PRIArobotics/Hedgehog_PCB/Doc/Pinout_STM_RPi.xlsx

Sheet: STM
Pin | Name | ADC | Timer |  |  | Com |  |  | Used For
1 | E2 |  |  |  |  | SPI4_SCK |  |  | IMU SCK
2 | E3 |  |  |  |  |  |  |  | IMU INT
3 | E4 |  |  |  |  | SPI4_NSS |  |  | IMU NCS
4 | E5 |  | TIM9_CH1 |  |  | SPI4_MISO |  |  | IMU MISO
5 | E6 |  | TIM9_CH2 |  |  | SPI4_MOSI |  |  | IMU MOSI
6 | VBAT |  |  |  |  |  |  |  | Power In Sense
7 | C13 |  |  |  |  |  |  |  | Motor 0/1 Mode
8 | C14-OSC32_IN |  |  |  |  |  |  |  | Motor 2 B
9 | C15-OSC32_OUT |  |  |  |  |  |  |  | Motor 3 B
10 | VSS
11 | VDD
12 | H0-OSC_IN |  |  |  |  |  |  |  | Crystal (optional)
13 | H1-OSC_OUT |  |  |  |  |  |  |  | Crystal (optional)
14 | NRST |  |  |  |  |  |  |  | NRST (controlled by RPi)
15 | C0 | ADC1_IN10 |  |  |  |  |  |  | IO_15 Analog
16 | C1 | ADC1_IN11 |  |  |  |  |  |  | IO_14 Analog
17 | C2 | ADC1_IN12 |  |  |  | SPI2_MISO |  |  | IO_7 Analog
18 | C3 | ADC1_IN13 |  |  |  | SPI2_MOSI |  |  | IO_6 Analog
19 | VDD
20 | VSSA, VREF-
21 | VREF+
22 | VDDA
23 | A0 | ADC1_IN0 | TIM2_CH1 | TIM5_CH1 |  | USART2_CTS |  |  | IO_5 Analog
24 | A1 | ADC1_IN1 | TIM2_CH2 | TIM5_CH2 |  | USART2_RTS |  |  | IO_4 Analog
25 | A2 | ADC1_IN2 | TIM2_CH3 | TIM5_CH3 | TIM9_CH1 | USART2_TX |  |  | IO_3 Analog
26 | A3 | ADC1_IN3 | TIM2_CH4 | TIM5_CH4 | TIM9_CH2 | USART2_RX |  |  | IO_2 Analog
27 | VSS
28 | VDD
29 | A4 | ADC1_IN4 |  |  |  | SPI1_NSS | SPI3_NSS | USART2_CK | IO_1 Analog
30 | A5 | ADC1_IN5 | TIM2_CH1 |  |  | SPI1_SCK |  |  | IO_0 Analog
31 | A6 | ADC1_IN6 | TIM3_CH1 |  |  | SPI1_MISO |  |  | IO_8 Analog
32 | A7 | ADC1_IN7 | TIM3_CH2 |  |  | SPI1_MOSI |  |  | IO_9 Analog
33 | C4 | ADC1_IN14 |  |  |  |  |  |  | IO_10 Analog
34 | C5 | ADC1_IN15 |  |  |  |  |  |  | IO_11 Analog
35 | B0 | ADC1_IN8 | TIM3_CH3 |  |  |  |  |  | IO_12 Analog
36 | B1 | ADC1_IN9 | TIM3_CH4 |  |  |  |  |  | IO_13 Analog
37 | B2 |  |  |  |  |  |  |  | PG REG MS
38 | E7 |  |  |  |  |  |  |  | Motor 3 A
39 | E8 |  | TIM1_CH1N |  |  |  |  |  | Speaker -
40 | E9 |  | TIM1_CH1 |  |  |  |  |  | Speaker +
41 | E10 |  |  |  |  |  |  |  | IO_13
42 | E11 |  | TIM1_CH2 |  |  | SPI4_NSS |  |  | IO_12
43 | E12 |  |  |  |  | SPI4_SCK |  |  | IO_11
44 | E13 |  | TIM1_CH3 |  |  | SPI4_MISO |  |  | IO_10
45 | E14 |  | TIM1_CH4 |  |  | SPI4_MOSI |  |  | IO_9
46 | E15 |  |  |  |  |  |  |  | IO_8
47 | B10 |  | TIM2_CH3 |  |  | SPI2_SCK | I2C2_SCL |  | Power LED
48 | VCAP_1
49 | VSS
50 | VDD
51 | B12 |  |  |  |  | SPI2_NSS | I2C2_SMBA |  | SPI EXT 1
52 | B13 |  |  |  |  | SPI2_SCK |  |  | SPI EXT 1
53 | B14 |  |  |  |  | SPI2_MISO |  |  | SPI EXT 1
54 | B15 |  |  |  |  | SPI2_MOSI |  |  | SPI EXT 1
55 | D8 |  |  |  |  |  |  |  | EN Reg RPi
56 | D9 |  |  |  |  |  |  |  | EN Reg MS
57 | D10 |  |  |  |  |  |  |  | EN PWR IN
58 | D11 |  |  |  |  |  |  |  | Power Button State
59 | D12 |  | TIM4_CH1 |  |  |  |  |  | Servo 5
60 | D13 |  | TIM4_CH2 |  |  |  |  |  | Servo 4
61 | D14 |  | TIM4_CH3 |  |  |  |  |  | Servo 3
62 | D15 |  | TIM4_CH4 |  |  |  |  |  | Servo 2
63 | C6 |  | TIM3_CH1 |  |  | USART6_TX |  |  | Servo 1
64 | C7 |  | TIM3_CH2 |  |  | USART6_RX |  |  | Servo 0
65 | C8 |  | TIM3_CH3 |  |  | USART6_CK |  |  | Motor 1 B
66 | C9 |  | TIM3_CH4 |  |  | I2C3_SDA |  |  | Motor 0 A
67 | A8 |  | TIM1_CH1 |  |  | I2C3_SCL | USART1_CK |  | Motor 2 A
68 | A9 |  | TIM1_CH2 |  |  | I2C3_SMBA | USART1_TX |  | UART to RPi
69 | A10 |  | TIM1_CH3 |  |  | USART1_RX |  |  | UART to RPi
70 | A11 |  | TIM1_CH4 |  |  | USART1_CTS | USART6_TX |  | UART EXT 1
71 | A12 |  |  |  |  | USART1_RTS | USART6_RX |  | UART EXT 1
72 | A13 |  |  |  |  |  |  |  | JTMS/SWDIO (controlled by RPi)
73 | V_CAP_2
74 | VSS
75 | VDD
76 | A14 |  |  |  |  |  |  |  | JTCK/SWCLK (controlled by RPi)
77 | A15 |  | TIM2_CH1 |  |  | SPI1_NSS | SPI3_NSS |  | JTDI (controlled by RPi)
78 | C10 |  |  |  |  | SPI3_SCK |  |  | RPi Active Sense
79 | C11 |  |  |  |  | SPI3_MISO |  |  | Motor 1 A
80 | C12 |  |  |  |  | SPI3_MOSI |  |  | Motor 0 B
81 | D0 |  |  |  |  |  |  |  | IO_0
82 | D1 |  |  |  |  |  |  |  | IO_1
83 | D2 |  |  |  |  |  |  |  | IO_2
84 | D3 |  |  |  |  | SPI2_SCK | USART2_CTS |  | IO_3
85 | D4 |  |  |  |  |  | USART2_RTS |  | IO_4
86 | D5 |  |  |  |  |  | USART2_TX |  | IO_5
87 | D6 |  |  |  |  | SPI3_MOSI | USART2_RX |  | IO_6
88 | D7 |  |  |  |  |  | USART2_CK |  | IO_7
89 | B3 |  | TIM2_CH2 |  |  | SPI1_SCK | SPI3_SCK | I2C_SDA | JTDO/SWO (controlled by RPi)
90 | B4 |  | TIM3_CH1 |  |  | SPI1_MISO | SPI3_MISO |  | NJTRST (controlled by RPi)
91 | B5 |  | TIM3_CH2 |  |  | SPI1_MOSI | SPI3_MOSI |  | Motor 2/3 Mode
92 | B6 |  | TIM4_CH1 |  |  | I2C1_SCL | USART1_TX |  | I2C EXT 1
93 | B7 |  | TIM4_CH2 |  |  | I2C1_SDA | USART1_RX |  | I2C EXT 1
94 | BOOT0 |  |  |  |  |  |  |  | BOOT0 (controlled by RPi)
95 | B8 |  | TIM4_CH3 | TIM10_CH1 |  | I2C1_SCL |  |  | LED0 (D40)
96 | B9 |  | TIM4_CH4 | TIM11_CH1 |  | SPI2_NSS | I2C1_SDA |  | LED1 (D41)
97 | E0 |  |  |  |  |  |  |  | IO_14
98 | E1 |  |  |  |  |  |  |  | IO_15
99 | VSS
100 | VDD

Sheet: RPi
Pin | Name | Com | Used for
1 | 3V3
2 | 5V
3 | GPIO02 | SDA | I2C EXT 0
4 | 5V
5 | GPIO03 | SCL | I2C EXT 0
6 | GND
7 | GPIO04
8 | GPIO14 | TXD | UART to STM
9 | GND
10 | GPIO15 | RXD | UART to STM
11 | GPIO17 |  | STM NJTRST
12 | GPIO18
13 | GPIO27 |  | STM JTDO/SWO
14 | GND
15 | GOIO22 |  | STM JTDI
16 | GPIO23 |  | EN PWR IN
17 | 3V3
18 | GPIO24 |  | EN Reg RPi
19 | GPIO10 | MOSI | SPI EXT 0
20 | GND
21 | GPIO09 | MISO | SPI EXT 0
22 | GPIO25
23 | GPIO11 | CLK | SPI EXT 0
24 | GPIO08 | CE0 | SPI EXT 0_0
25 | GND
26 | GPIO07 | CE1 | SPI EXT 0_1
27 | ID_SD
28 | ID_SC
29 | GPIO05 |  | STM NRST
30 | GND
31 | GPIO06 |  | STM BOOT0
32 | GPIO12
33 | GPIO13 |  | STM JTCK/SWCLK
34 | GND
35 | GPIO19 |  | STM JTMS/SWDIO
36 | GPIO16 |  | RPi Active Output
37 | GPIO26 |  | STM NRST EN
38 | GPIO20 |  | LED3 (D43)
39 | GND
40 | GPIO21 |  | LED2 (D42)
