PRIArobotics/Hedgehog_PCB/Doc/Assembly_RefDes.pdf

R44C11

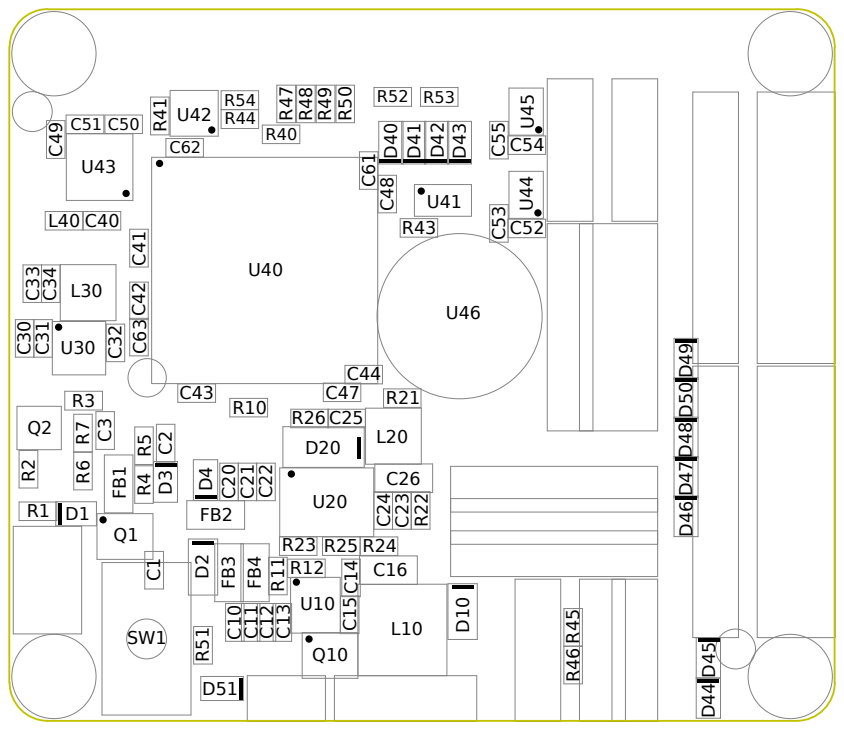
[picture p1: page 1]

R23 | R25 | R24
R12 | | | C16
