PRIArobotics/Hedgehog_PCB/Doc/Assembly_Mask.pdf

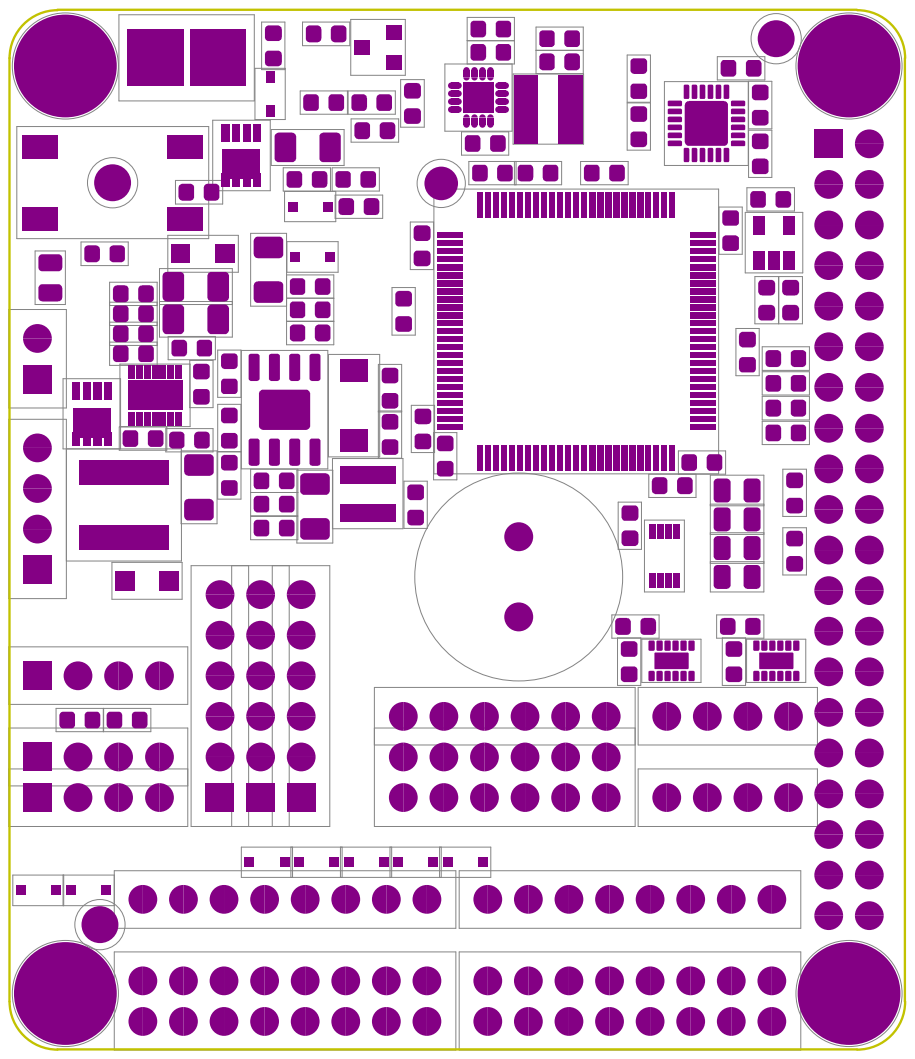
[picture p2: page 1]
