PRIArobotics/Hedgehog_PCB/(commit log)

2017-03-23 added motor driver to libraries
2017-04-18 Added hierarchical Design on Top Layer in eschematic.
    Added File for 3V3-regulator, Switching Regulator for RPI and Switching Regulator Motor and Servo. Added File for Hedgehog Logic design, which include the microcontroller-, Motordriverschematic,…
    [3V3-Regler.sch, Logic_Hedgehog.sch, Motortreiber.sch, STM.sch, Schaltregler_Motor_Servo.sch, Schaltregler_Raspberry.sch]
2017-04-18 Added IMU schematic -> InvenSense-ICM-20689
    [3V3-Regler.sch, Hedgehog.sch, Logic_Hedgehog.sch, Motortreiber.sch, STM.sch, Schaltregler_Motor_Servo.sch, Schaltregler_Raspberry.sch]
2017-04-19 Added MOSFET component Added Button component Added On-Off-Switch schematic
    [3V3-Regler.sch, Hedgehog.sch, Motortreiber.sch]
2017-04-19 Added Piezo Buzzer in Libray Added Piezo Buzzer schematic Added Pinout for STM32 SWDIO / JTAG is missing
    [Hedgehog.sch, Logic_Hedgehog.sch]
2017-04-21 placed Battery measurement circuit behind mosfet and added a zener diode
    [Hedgehog.sch]
2017-04-30 Added IMU Files
    [IMU.sch]
2017-04-30 removed duplicateproject file
    [Hedgehog.kicad_pcb]
2017-04-30 added pcb backup file
2017-04-30 more cleanup
    [Logic_Hedgehog.sch, Motor_Drivers.sch]
2017-04-30 added mosfet footprint some more cleanup
    [Hedgehog.sch, IMU.sch, Logic_Hedgehog.sch]
2017-04-30 added RPi Regulator added ref.des.-prefixes to all schematic sheets
    [Hedgehog.sch, IMU.sch, Logic_Hedgehog.sch, Motor_Drivers.sch, Reg_3V3.sch, Reg_5V_MS.sch, Reg_5V_RPi.sch, STM.sch]
2017-04-30 added 3v3 regulator
    [Hedgehog.sch, Reg_3V3.sch, Reg_5V_RPi.sch]
2017-04-30 added note
    [Reg_5V_MS.sch]
2017-05-01 added Motor/Servo 5V regulator
    [Hedgehog.sch, Reg_3V3.sch, Reg_5V_MS.sch]
2017-05-04 moved stuff from other sheet to Logic sheet cleanup added connections schematic nearly finished
    [Hedgehog.sch, IMU.sch, Logic_Hedgehog.sch, Motor_Drivers.sch, Reg_3V3.sch, Reg_5V_MS.sch, Reg_5V_RPi.sch, STM.sch]
2017-05-04 changed zener values added comments
    [Hedgehog.sch, Logic_Hedgehog.sch, Reg_3V3.sch]
2017-05-05 Added Symbolnames
    [Hedgehog.sch, Logic_Hedgehog.sch, Reg_3V3.sch, Reg_5V_MS.sch, Reg_5V_RPi.sch]
2017-05-05 linked some footprints
    [Hedgehog.sch, Logic_Hedgehog.sch, Reg_3V3.sch, Reg_5V_MS.sch, Reg_5V_RPi.sch]
2017-05-14 added reset and power control stuff, changed some ref.des.
    [Hedgehog.sch, Logic_Hedgehog.sch, Reg_3V3.sch, Reg_5V_MS.sch, Reg_5V_RPi.sch]
2017-05-14 changed layout settings, added outline and mounting holes
    [Hedgehog.kicad_pcb]
2017-05-24 added footprint for Buzzer, Pushbutton and HSOP-8
    [Hedgehog.sch, Logic_Hedgehog.sch, Reg_3V3.sch, Reg_5V_MS.sch, Reg_5V_RPi.sch]
2017-05-24 added HSOP-8,LSON-22,Mini-F3-B,MSOP-10,SOD323F Footprint finished package assignment (without inductors )
    [Hedgehog.sch, Logic_Hedgehog.sch, Reg_3V3.sch, Reg_5V_MS.sch, Reg_5V_RPi.sch]
2017-05-25 pushed forgotten footprints
2017-05-25 fixed some footprints, should now be correct and complete
    [Hedgehog.kicad_pcb, Hedgehog.sch, Logic_Hedgehog.sch, Reg_3V3.sch, Reg_5V_MS.sch, Reg_5V_RPi.sch]
2017-05-25 started layout
    [Hedgehog.kicad_pcb, Hedgehog.sch, Logic_Hedgehog.sch, Reg_3V3.sch]
2017-05-31 more layouting done, schematic changed slightly
    [Hedgehog.kicad_pcb, Logic_Hedgehog.sch]
2017-06-01 more layouting done, just regulators missing
    [Hedgehog.kicad_pcb, Hedgehog.sch, Logic_Hedgehog.sch]
2017-07-18 changed L and D of RPi 5V reg, all components on one side, everything routed, silkscreen unfinished
    [Hedgehog.kicad_pcb, Logic_Hedgehog.sch, Reg_3V3.sch, Reg_5V_MS.sch, Reg_5V_RPi.sch]
2017-07-18 probably the final version for the prototypes, gerbers added
    [Hedgehog-B.Cu.gbl, Hedgehog-B.Mask.gbs, Hedgehog-B.SilkS.gbo, Hedgehog-Edge.Cuts.gm1, Hedgehog-F.Cu.gtl, Hedgehog-F.Mask.gts, Hedgehog-F.Paste.gtp, Hedgehog-F.SilkS.gto]
2017-07-19 just small changes
    [Hedgehog-B.Cu.gbl, Hedgehog-B.Mask.gbs, Hedgehog-B.SilkS.gbo, Hedgehog-Edge.Cuts.gm1, Hedgehog-F.Cu.gtl, Hedgehog-F.Mask.gts, Hedgehog-F.Paste.gtp, Hedgehog-F.SilkS.gto]
2017-07-29 added thermals to gnd and 3v3 tht pads
    [Hedgehog-B.Cu.gbl, Hedgehog-B.Mask.gbs, Hedgehog-B.SilkS.gbo, Hedgehog-Edge.Cuts.gm1, Hedgehog-F.Cu.gtl, Hedgehog-F.Mask.gts, Hedgehog-F.Paste.gtp, Hedgehog-F.SilkS.gto]
2017-08-01 slightly modified copper pours and thermals
    [Hedgehog-B.Cu.gbl, Hedgehog-B.Mask.gbs, Hedgehog-B.SilkS.gbo, Hedgehog-Edge.Cuts.gm1, Hedgehog-F.Cu.gtl, Hedgehog-F.Mask.gts, Hedgehog-F.Paste.gtp, Hedgehog-F.SilkS.gto]
2017-08-11 added assembly documentation
2017-10-29 lots of changes: - incremented version number to 0.2 - all inputs are now analog, vbat for supply voltage monitoring - 6 servos - different 5v 10A regulator - changed input order - footprint fixes an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
    [Hedgehog-B.Cu.gbl, Hedgehog-B.Mask.gbs, Hedgehog-B.SilkS.gbo, Hedgehog-Edge.Cuts.gm1, Hedgehog-F.Cu.gtl, Hedgehog-F.Mask.gts, Hedgehog-F.Paste.gtp, Hedgehog-F.SilkS.gto]
2017-10-29 small changes
    [Hedgehog-B.Cu.gbl, Hedgehog-B.Mask.gbs, Hedgehog-B.SilkS.gbo, Hedgehog-Edge.Cuts.gm1, Hedgehog-F.Cu.gtl, Hedgehog-F.Mask.gts, Hedgehog-F.Paste.gtp, Hedgehog-F.SilkS.gto]
2017-10-29 small silk change, added assembly doc
    [Hedgehog-B.Cu.gbl, Hedgehog-B.Mask.gbs, Hedgehog-B.SilkS.gbo, Hedgehog-Edge.Cuts.gm1, Hedgehog-F.Cu.gtl, Hedgehog-F.Mask.gts, Hedgehog-F.Paste.gtp, Hedgehog-F.SilkS.gto]
2017-10-30 changed gerber settings
    [Hedgehog-B.Cu.gbl, Hedgehog-B.Mask.gbs, Hedgehog-B.SilkS.gbo, Hedgehog-Edge.Cuts.gm1, Hedgehog-F.Cu.gtl, Hedgehog-F.Mask.gts, Hedgehog-F.Paste.gtp, Hedgehog-F.SilkS.gto]
2017-10-30 component values changed documentation added
    [BOM.xlsx, Hedgehog.kicad_pcb, Hedgehog.sch, Logic_Hedgehog.sch, Pinout_STM_RPi.xlsx, Reg_3V3.sch, Reg_5V_MS.sch, Reg_5V_RPi.sch]
2017-11-02 changed version to 0.3 changed input mosfet & gate zener changed D2 to simplify bom
    [BOM.xlsx, Hedgehog.kicad_pcb, Hedgehog.sch, Reg_3V3.sch]
2017-11-06 Pinout Corrected, motor and servo netnames sitill wrong small bom change
    [BOM.xlsx, Pinout_STM_RPi.xlsx]
2017-11-27 fixed library dependences, swapped inner layers
    [Hedgehog-B.Cu.gbl, Hedgehog-B.Mask.gbs, Hedgehog-B.SilkS.gbo, Hedgehog-Edge.Cuts.gm1, Hedgehog-F.Cu.gtl, Hedgehog-F.Mask.gts, Hedgehog-F.Paste.gtp, Hedgehog-F.SilkS.gto]
2018-02-01 multiple changes for v0.3: added 24V zener to catch input voltage spikes added pulldown to RPi reset enable removed zener from input voltage sense changed input voltage divider ratio connected power 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
    [BOM.xlsx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]
2018-02-06 upgraded project to new kicad symbol library format
    [Hedgehog.kicad_pcb, Hedgehog.sch, Logic_Hedgehog.sch, Reg_3V3.sch, Reg_5V_MS.sch, Reg_5V_RPi.sch]
2018-02-06 added and removed some things
    [Hedgehog-B.Cu.gbl, Hedgehog-B.Mask.gbs, Hedgehog-B.SilkS.gbo, Hedgehog-Edge.Cuts.gm1, Hedgehog-F.Cu.gtl, Hedgehog-F.Mask.gts, Hedgehog-F.Paste.gtp, Hedgehog-F.SilkS.gto]
2018-02-19 corrected bom
    [BOM.xlsx]
2018-10-25 lots of changes: regulator layout improved bom minimized inner top layer completely gnd UB single pole pullups for use without pi swiched to new kicad version and fp lib motor and servo netanmes fixe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
    [BOM.xlsx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]
2018-10-26 changed 3V3 regulator to different IC D20 smaller added 5V RPi Reg EN pulldown
    [Hedgehog.kicad_pcb, Hedgehog.sch, Logic.sch, Reg_3V3.sch, Reg_5V_RPi.sch]
2018-10-26 regulator gnd plane improvements (hopefully) gnd via stiching
    [Hedgehog.kicad_pcb]
2018-10-29 Updated documentation and other small changes
    [BOM.xlsx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]
2019-05-12 changes for first production version v1.0: added bootstrap resistor R26 R54 Pullup 5V MS Zones bigger U10 Pin7 GND silk improvements version changed: silk, sch & pcb pages updated doc files
    [BOM.xlsx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]
2019-05-13 added diode polarity to assembly documentation
2019-05-13 added thermal relieves to hand soldered C45 and C46 ground pads
    [Hedgehog-B_Cu.gbl, Hedgehog-B_Mask.gbs, Hedgehog-B_SilkS.gbo, Hedgehog-Edge_Cuts.gm1, Hedgehog-F_Cu.gtl, Hedgehog-F_Mask.gts, Hedgehog-F_Paste.gtp, Hedgehog-F_SilkS.gto]
2019-05-14 fixed small drc violations, added x2 gerbers
    [Hedgehog-B_Cu.gbl, Hedgehog-B_Mask.gbs, Hedgehog-B_SilkS.gbo, Hedgehog-Edge_Cuts.gm1, Hedgehog-F_Cu.gtl, Hedgehog-F_Mask.gts, Hedgehog-F_Paste.gtp, Hedgehog-F_SilkS.gto]
2020-01-09 updated gerber files, previous version had some too small paste aperatures. probably caused by a bug in the older kicad version, no settings were changed.
    [Hedgehog-B_Cu.gbl, Hedgehog-B_Mask.gbs, Hedgehog-B_SilkS.gbo, Hedgehog-Edge_Cuts.gm1, Hedgehog-F_Cu.gtl, Hedgehog-F_Mask.gts, Hedgehog-F_Paste.gtp, Hedgehog-F_SilkS.gto]
